Keyzoo0/sistem-penggiling-biji-kopi-berbasis-fuzzy-dan-pid-order-satu/ESP32_Firmware/params.cpp

#include "params.h"
#include "config.h"
#include <Preferences.h>

static Preferences prefs;
#define PARAMS_NS "kopiprm"

void paramsLoad(SystemState& st) {
  prefs.begin(PARAMS_NS, true);                 // read-only
  st.Kp         = prefs.getFloat("kp",   DEF_KP);
  st.Ki         = prefs.getFloat("ki",   DEF_KI);
  st.Kd         = prefs.getFloat("kd",   DEF_KD);
  st.lambda     = prefs.getFloat("lam",  DEF_LAMBDA);
  st.mu         = prefs.getFloat("mu",   DEF_MU);
  st.beta       = prefs.getFloat("beta", DEF_BETA);
  st.setPoint   = prefs.getFloat("sp",   DEF_SETPOINT);
  st.durationMin= prefs.getULong("dur",  DEF_DURATION_MIN);
  st.servoDeg   = prefs.getInt(  "servo", SERVO_MAX);
  st.freqMotor  = prefs.getFloat("freq", DEF_FREQ_MOTOR);
  st.profile    = (Profile)prefs.getUChar("prof", (uint8_t)PROF_WAFI);
  st.speedSP    = prefs.getFloat("ssp", DEF_SPEED_SP);
  st.sKp        = prefs.getFloat("skp", DEF_SKP);
  st.sKi        = prefs.getFloat("ski", DEF_SKI);
  st.sKd        = prefs.getFloat("skd", DEF_SKD);
  st.blowerConst= prefs.getInt(  "bcon", DEF_BLOWER_CONST);
  prefs.end();
  Serial.printf("[PARAMS] load: Kp=%.3f Ki=%.3f Kd=%.3f SP=%.1f dur=%lu servo=%d freq=%.1f\n",
                st.Kp, st.Ki, st.Kd, st.setPoint, (unsigned long)st.durationMin, st.servoDeg, st.freqMotor);
}

void paramsSave(const SystemState& st) {
  prefs.begin(PARAMS_NS, false);
  prefs.putFloat("kp",   st.Kp);
  prefs.putFloat("ki",   st.Ki);
  prefs.putFloat("kd",   st.Kd);
  prefs.putFloat("lam",  st.lambda);
  prefs.putFloat("mu",   st.mu);
  prefs.putFloat("beta", st.beta);
  prefs.putFloat("sp",   st.setPoint);
  prefs.putULong("dur",  st.durationMin);
  prefs.putInt(  "servo", st.servoDeg);
  prefs.putFloat("freq", st.freqMotor);
  prefs.putUChar("prof", (uint8_t)st.profile);
  prefs.putFloat("ssp", st.speedSP);
  prefs.putFloat("skp", st.sKp);
  prefs.putFloat("ski", st.sKi);
  prefs.putFloat("skd", st.sKd);
  prefs.putInt(  "bcon", st.blowerConst);
  prefs.end();
}
