Keyzoo0/sistem-penggiling-biji-kopi-berbasis-fuzzy-dan-pid-order-satu/(commit log)

2026-06-26 Initial commit: FoPID+Fuzzy Blower Control v19+WS
    ESP32 firmware dengan:
    - Fuzzy Logic + FoPID hybrid control
    - MLX90614, DS3231 RTC, Keypad I2C, LCD 20x4
    - RBDdimmer AC control + Servo
    - Web Server (ESPAsyncWebServer + WebSocket)
    - LittleFS web dashboard (Chart.js real-time)
    - SD Card logging CSV
2026-06-26 fix: lcdLine pad to 20 chars, hapus orphan code
    [ESP32_Firmware.ino]
2026-06-28 refactor: arsitektur modular + dual-core FreeRTOS, safety supervisor, metode kontrol blower non-monoton (fuzzy+FoPID), dashboard offline + simulator
    - Pecah monolit jadi modul (config/state/sensors/actuators/control/safety/ui/webserver/logging)
    - Dual-core FreeRTOS + command queue + mutex (anti race web vs loop)
    - Safety supervisor: over-temp, sensor-fail, countdown (non-blocking)
    - Metode kontrol blower diperbaiki utk plant non-monoton (lihat tools/control_sim.py)
    - Dashboard web bespoke, offline (tanpa CDN), responsif
    - ARCHITECTURE.md blueprint + simulator kontrol
    [ESP32_Firmware.ino, Fis_Header.h, actuators.cpp, actuators.h, config.h, control.cpp, control.h]
2026-06-28 refactor: modular + dual-core FreeRTOS, safety, metode kontrol blower non-monoton (fuzzy+FoPID), dashboard offline, README interaktif
    - Safety supervisor non-blocking: over-temp, sensor-fail, e-stop, auto-stop durasi
    - Kontrol blower utk plant non-monoton + simulator tools/control_sim.py
    - Dashboard web bespoke offline (tanpa CDN), responsif
    - Kredensial WiFi dipindah ke secrets.h (gitignore), config pakai __has_include
    - ARCHITECTURE.md + README.md interaktif
    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
    [config.h]
2026-06-28 docs: REWORK_PLAN.md v2 — dua profil (Wafi suhu / Fadel kecepatan VFD), logger+grafik+riwayat, keputusan terkunci
2026-06-28 feat(control): kurva Wafi v2 — FIS 30->20->0(deadband)->60-100, FoPID trim tunable
    - Fis_Header.h: 4 MF, output ke band panas 20-30 & dingin 60-100
    - control.cpp: override deadband +-1% SP -> blower 0 (DEADBAND_BLOWER), FoPID trim di luar deadband
    - config.h: DIMMER_MAX 100, deadband, gain trim lembut
    - tools/control_sim.py: twin diperbarui & diverifikasi (rise 1.2m, overshoot ~0%, osilasi 0.5%)
    [Fis_Header.h, config.h, control.cpp]
2026-06-28 feat(params): tunable params persist NVS + /api/params + tuning via WS; fix sinkron input web
    - params.* : load/save Kp/Ki/Kd/lambda/mu/beta/setpoint/durasi/servo/freq ke Preferences
    - servo NVS dipindah dari actuators -> params (satu sumber)
    - field freqMotor (Wafi) + CMD_SET_FREQ; paramsSave saat SET command
    - web: load nilai input SEKALI via /api/params, hapus penimpaan telemetri
    - Verified: compile OK (94%), headless test input tidak ketimpa
    [ESP32_Firmware.ino, actuators.cpp, actuators.h, config.h, params.cpp, params.h, state.cpp]
2026-06-28 feat(logger): rekam 5 dtk ke folder SD per-profil + tab grafik riwayat
    - logging: interval 5s, folder /log/wafi, list path lengkap, download proteksi /log/
    - web: card riwayat klik -> modal grafik full-durasi (sumbu-x menit dari t0)
    - metrik: rise time (mnt) + penanda sentuh SP, overshoot %, osilasi %
    - tombol Download CSV + Download JPG (canvas.toDataURL)
    - Verified: compile OK + headless test (metrik terhitung, modal render, JPG valid)
    [config.h, logging.cpp, webserver.cpp]
2026-06-28 feat(vfd): modul Modbus RTU VFD (Serial1+MAX485, CRC cocok dokumen) + EMA filter encoder
    - vfd.* : writeRegister FC06/readRegister FC03, vfdRun/Stop/SetFrequency, DE/RE GPIO4
    - config: pin RS485 (Serial1 26/27, DE/RE 4), register VFD, RPM_EMA_ALPHA
    - sensors: ganti moving-average RPM -> EMA filter (lebih stabil)
    - vfdInit() di setup; CRC16 diverifikasi cocok dokumen (01 06 20 00 00 01 43 CA)
2026-06-28 feat(profil): backbone Wafi/Fadel + PID kecepatan VFD (firmware)
    - types/state: enum Profile, field speedSP/sKp/sKi/sKd/blowerConst/vfdFreq
    - control_speed.* : PID RPM->frekuensi VFD
    - realtime: cabang per profil (Wafi=suhu->blower, Fadel=kecepatan->VFD)
    - vfdTask (core0): tulis run/freq ke VFD, isolasi latensi Modbus dari loop kontrol
    - logging per profil: /log/wafi & /log/fadel
    - params: persist profil + speedSP + sKp/sKi/sKd + blowerConst
    - webserver: telemetri+params+command profil/speed
    - Verified: compile OK (94%)
2026-06-28 feat(web): dashboard 2 tab — Wafi (suhu) & Fadel (kecepatan)
    - tab switcher; Wafi: +input freq motor + kartu tuning Kp/Ki/Kd/lambda/mu/beta
    - Fadel: hero RPM + chart, kendali kecepatan (speedSP/gas/blower const/durasi), VFD freq, tuning PID kecepatan
    - chart factory (suhu+rpm), render per-profil, switch tab kirim {profile}
    - grafik riwayat: Fadel plot RPM vs target (log setpoint per-profil)
    - Verified: compile OK + headless test 2 tab (render, tuning ter-load, screenshot)
2026-06-29 feat: kontrol LCD/keypad penuh + sinkron web + manual book
    Antarmuka & sinkronisasi:
    - LCD 20x4 + keypad dirombak total jadi page-based & profil-aware (ui.cpp):
    4 layar (Monitor/Menu/Param/Edit), kontrol semua fungsi + tuning semua
    parameter dari keypad. Sinkron penuh dgn web via command queue + g_state
    ('last control wins'); ganti profil di keypad <-> web saling mengikuti.
    - Fadel: mode Manual (freq VFD langsung, CMD_SET_VFD) selain PID.
    - Riwayat logger dipisah per profil; kunci pindah tab saat proses berjalan;
    judul web dinamis per tab; tooltip '?' tiap parameter (peran/efek/saran).
    - CMD_SET_BLOWER persist NVS saat SIAGA (blower konstan Fadel).
    Dokumentasi:
    - README: Manual Book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
