Keyzoo0/sistem-penggiling-biji-kopi-berbasis-fuzzy-dan-pid-order-satu/(notices)

Notices in the files:
README.md:
License: MIT
